Vulpes271/lap-timer/cad/LapTimerPrototype/exports/preview_bezel_back.png

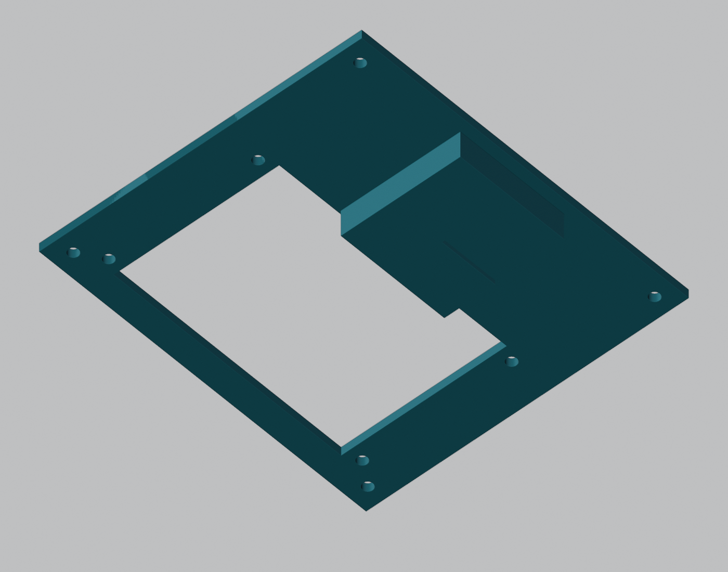
cad/LapTimerPrototype/exports/preview_bezel_back.png
