Vulpes271/lap-timer/cad/LapTimerPrototype/exports/preview_exploded.png

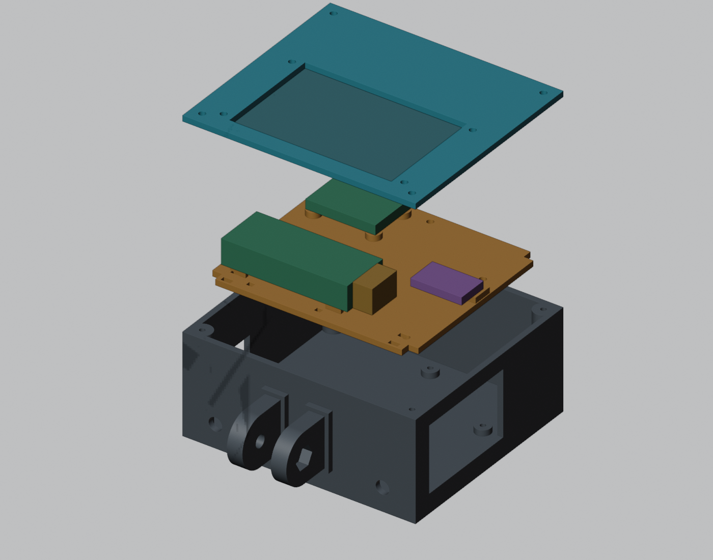
cad/LapTimerPrototype/exports/preview_exploded.png
