Vulpes271/lap-timer/cad/LapTimerPrototype/exports/preview_inside.png

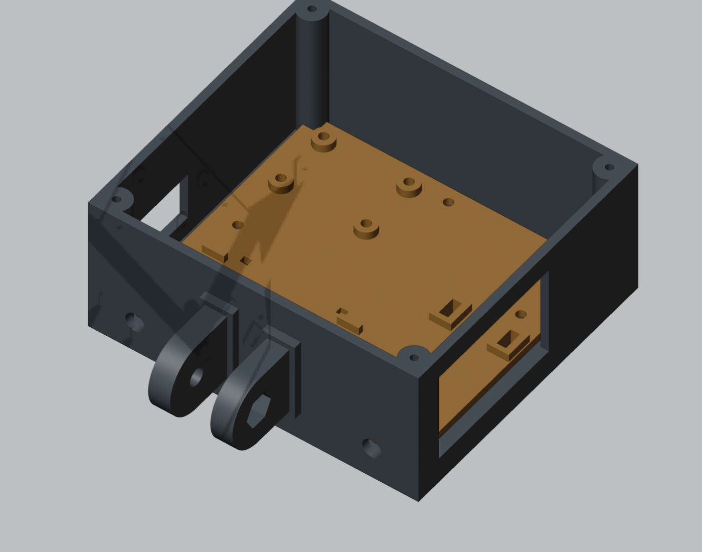
cad/LapTimerPrototype/exports/preview_inside.png
