Vulpes271/lap-timer/hardware/quote_v0/preview/architecture.png

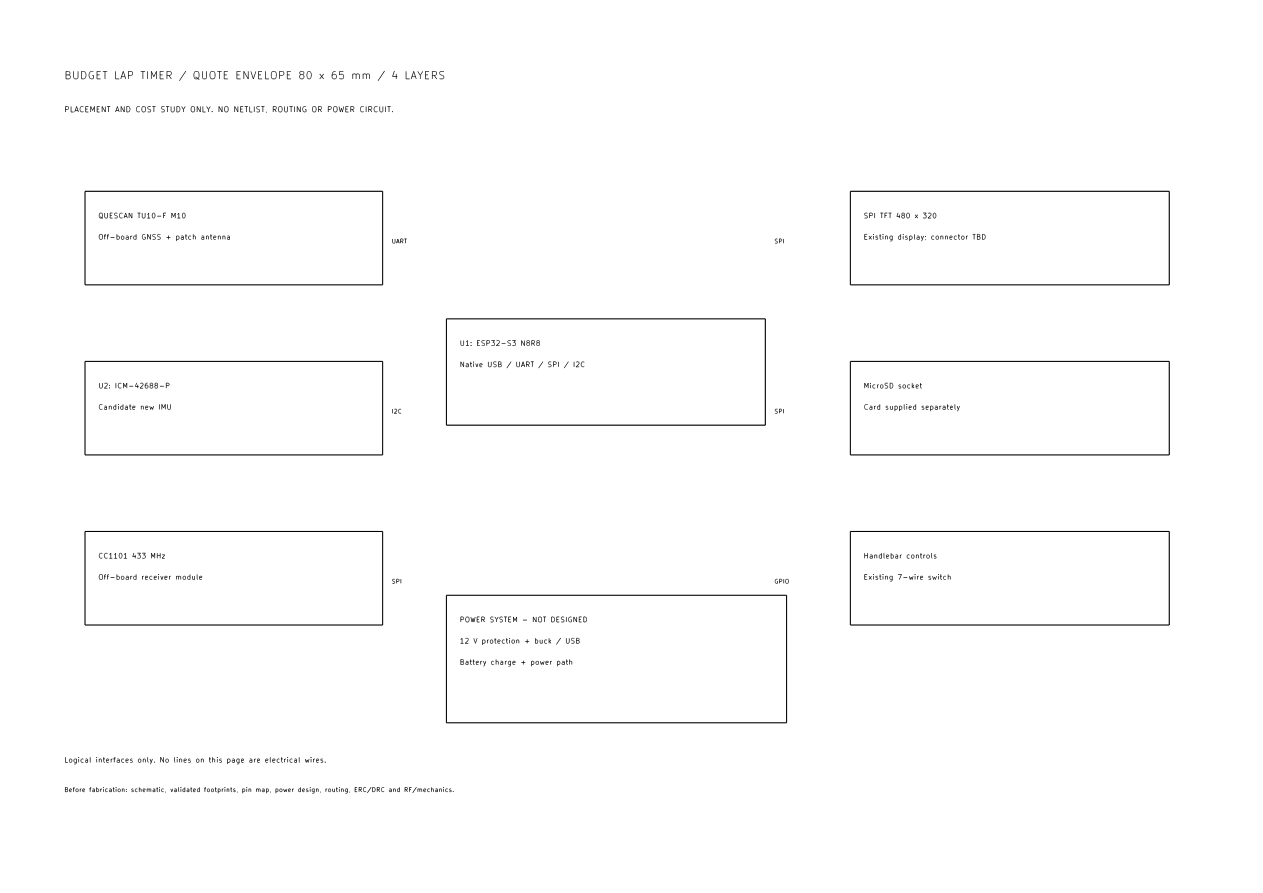
hardware/quote_v0/preview/architecture.png
