Vulpes271/lap-timer/hardware/quote_v0/preview/pcb_preview.png

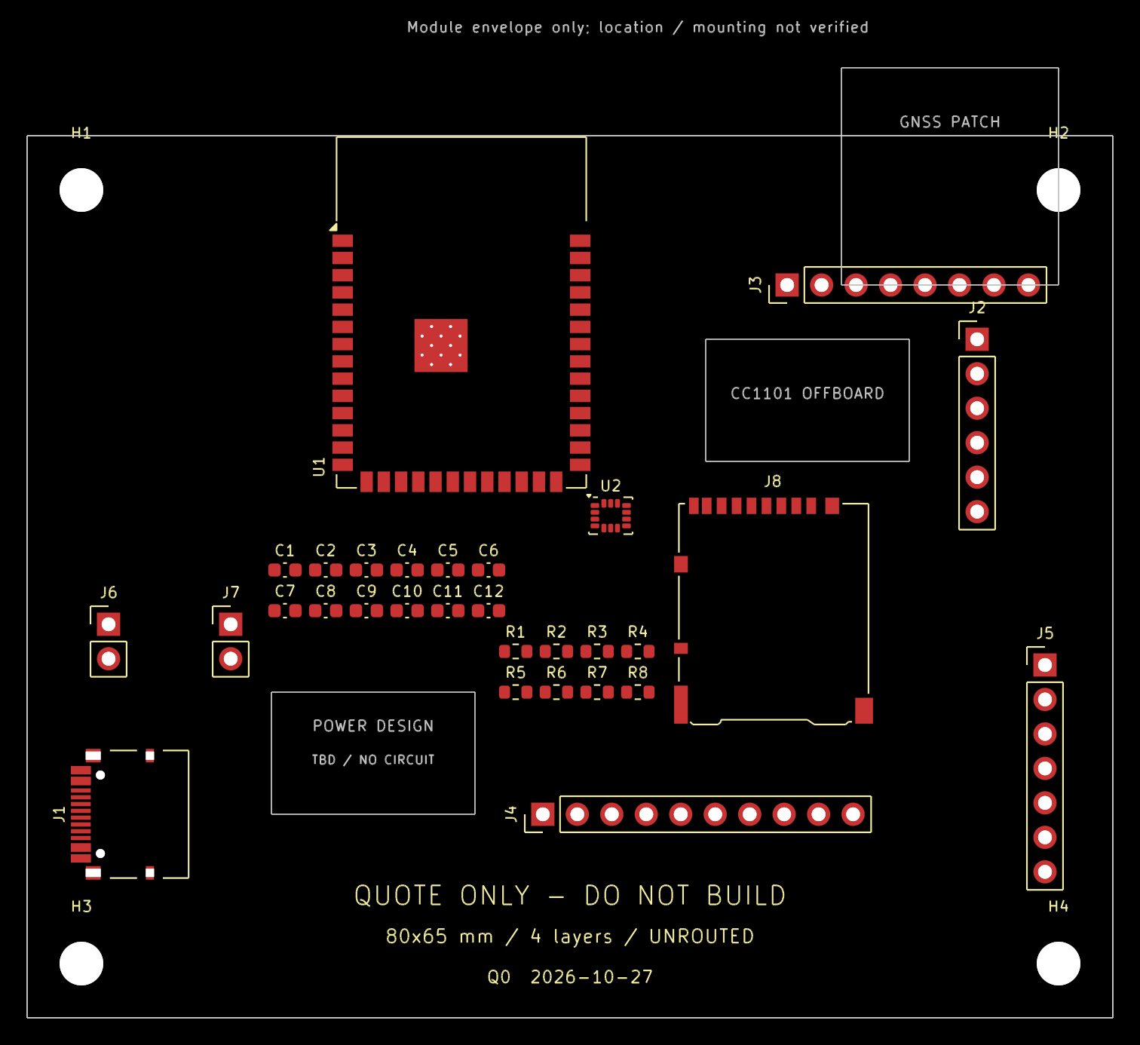
hardware/quote_v0/preview/pcb_preview.png
