Vulpes271/lap-timer/hardware/quote_v0/pcba_quote_subset/BOM_PARTIAL_QUOTE_ONLY.csv

Comment | Designator | Footprint | LCSC Part #
ESP32-S3-WROOM-1-N8R8 | U1 | ESP32-S3-WROOM-1 | C2913201
ICM-42688-P | U2 | LGA-14_3x2.5mm_P0.5mm_LayoutBorder3x4y | C1850418
