Vulpes271/lap-timer/cad/LapTimerPrototype/exports/LapTimer_assembled.step

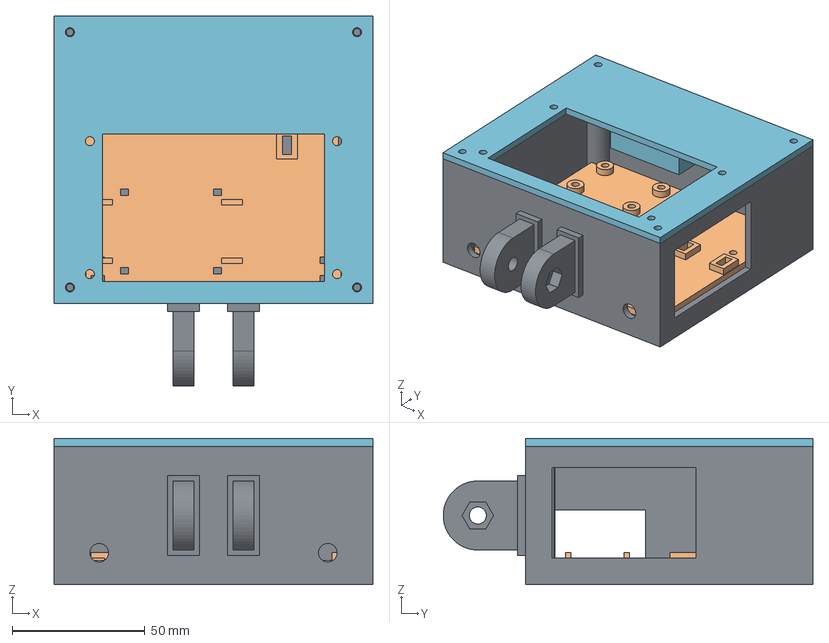
[picture p6: CAD file, 2026-11-06]
cad/LapTimerPrototype/exports/LapTimer_assembled.step
120.0 x 139.0 x 55.0 mm
01_Housing
02_Front_bezel
03_Electronics_carrier
