Vulpes271/lap-timer/cad/LapTimerPrototype/exports/02_Front_bezel.step

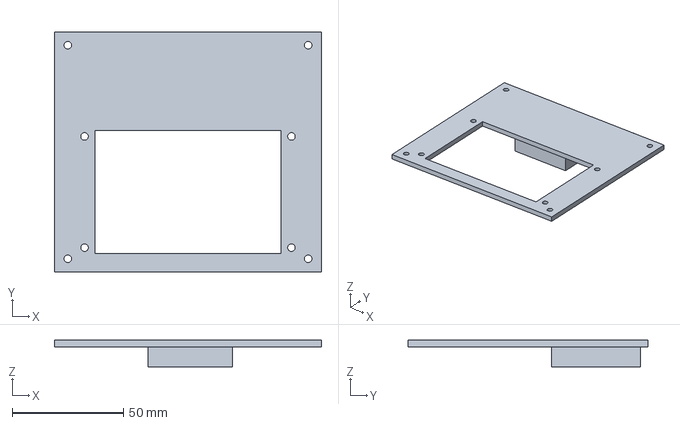
[picture p7: CAD file, 2026-11-06]
cad/LapTimerPrototype/exports/02_Front_bezel.step
120.0 x 108.0 x 12.0 mm
