Vulpes271/lap-timer/cad/LapTimerPrototype/exports/01_Housing.step

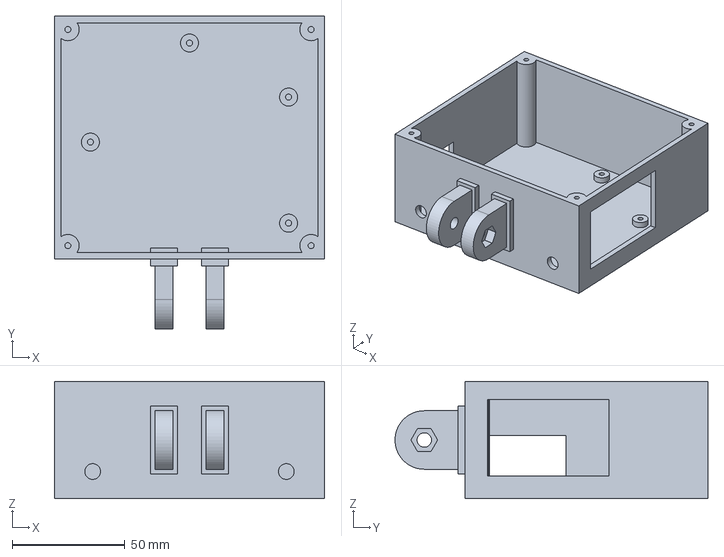
[picture p8: CAD file, 2026-11-06]
cad/LapTimerPrototype/exports/01_Housing.step
120.0 x 139.0 x 52.0 mm
