Vulpes271/lap-timer/cad/LapTimerPrototype/exports/03_Electronics_carrier.step

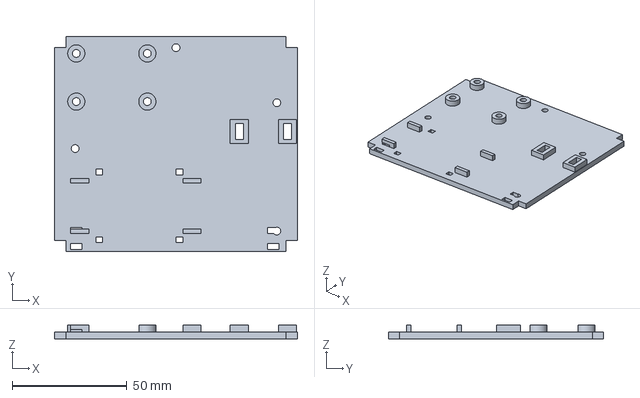
[picture p9: CAD file, 2026-11-06]
cad/LapTimerPrototype/exports/03_Electronics_carrier.step
106.0 x 94.0 x 6.00 mm
