Vulpes271/lap-timer/cad/LapTimerPrototype/exports/LapTimer_exploded.step

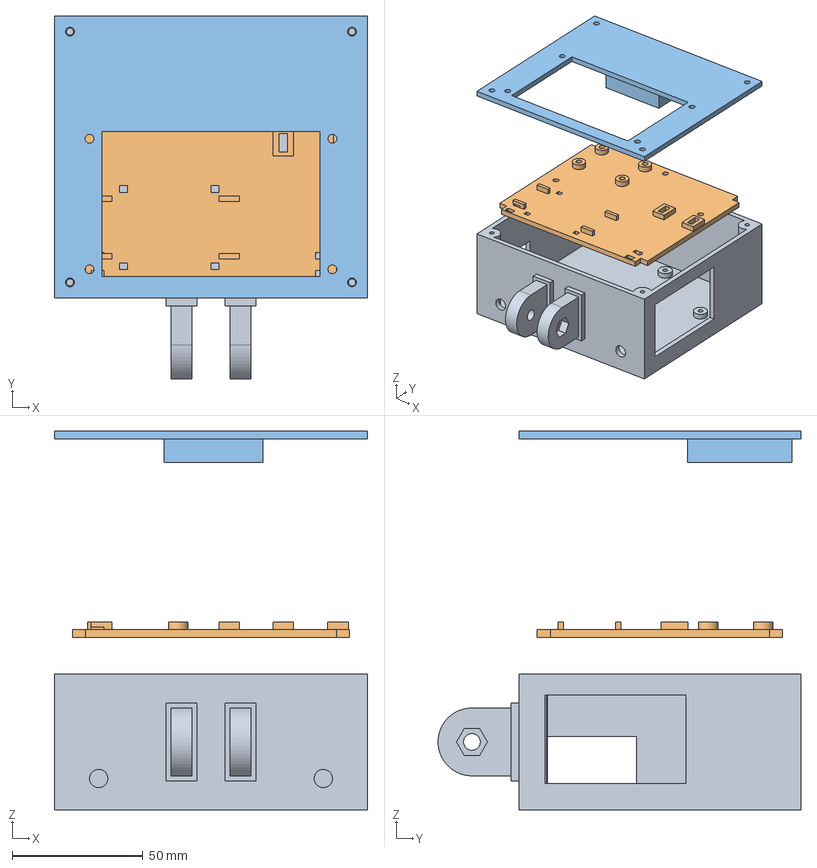
[picture p10: CAD file, 2026-11-06]
cad/LapTimerPrototype/exports/LapTimer_exploded.step
120.0 x 139.0 x 145.0 mm
01_Housing
03_Electronics_carrier
02_Front_bezel
