Vulpes271/lap-timer/cad/LapTimerPrototype/exports/04_Hinge_tongue_fit_gauge.step

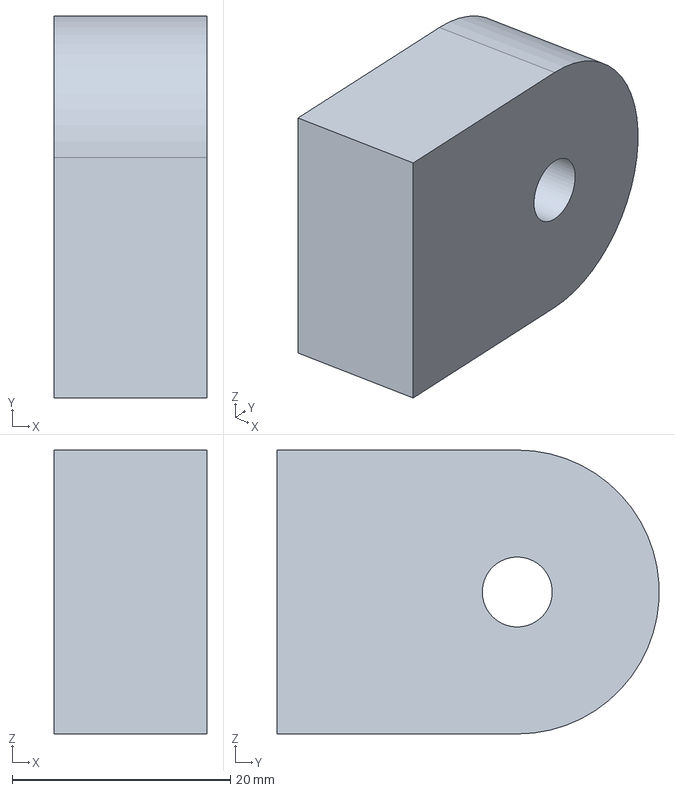
[picture p11: CAD file, 2026-11-06]
cad/LapTimerPrototype/exports/04_Hinge_tongue_fit_gauge.step
14.0 x 35.0 x 26.0 mm
