Vulpes271/lap-timer/cad/LapTimerPrototype/exports/05_Display_spacer_6mm.step

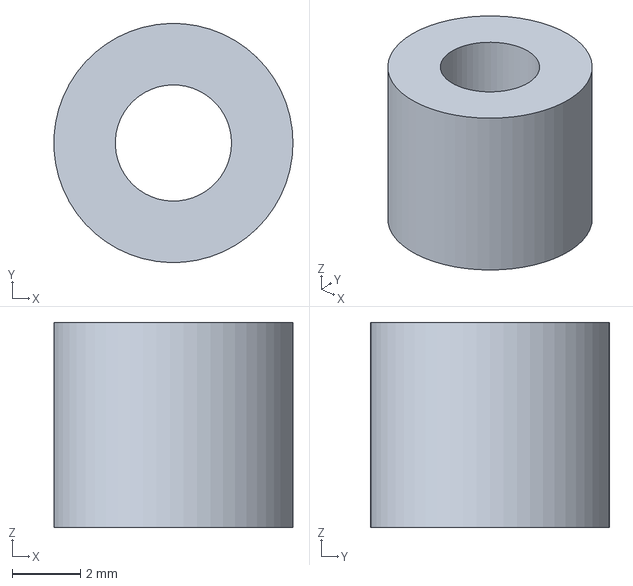
[picture p12: CAD file, 2026-11-06]
cad/LapTimerPrototype/exports/05_Display_spacer_6mm.step
6.99 x 7.00 x 6.00 mm
