Vulpes271/lap-timer/cad/LapTimerPrototype/exports/05_Display_spacer_2mm.step

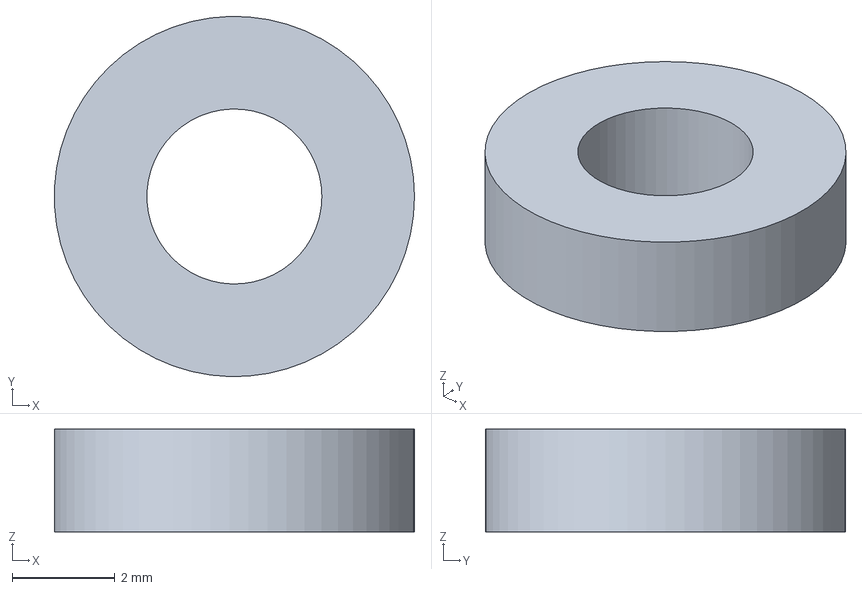
[picture p13: CAD file, 2026-11-06]
cad/LapTimerPrototype/exports/05_Display_spacer_2mm.step
7.00 x 7.00 x 2.00 mm
