Vulpes271/lap-timer/cad/LapTimerPrototype/exports/05_Display_spacer_4mm.step

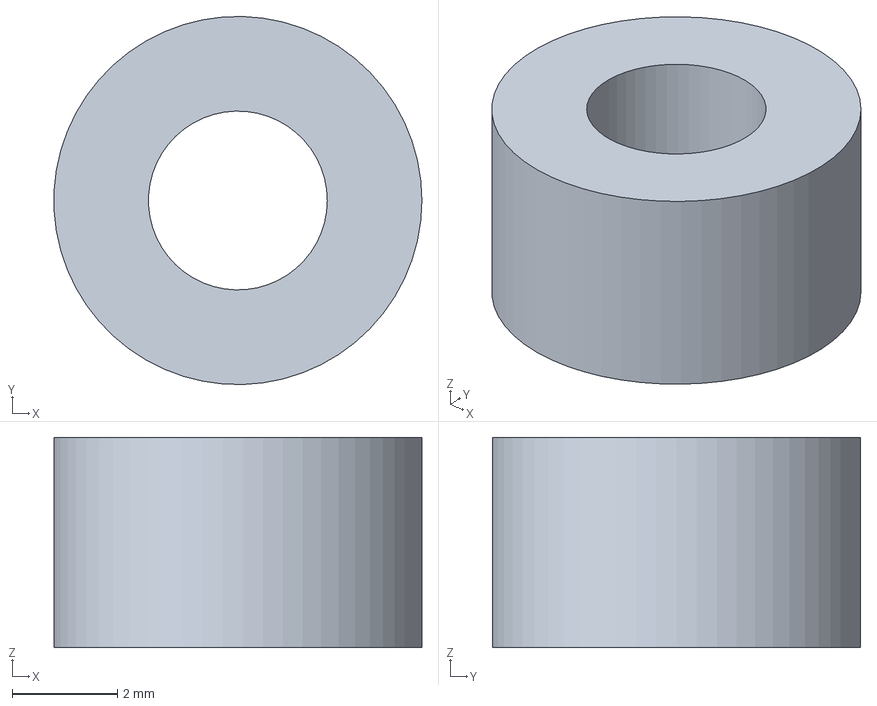
[picture p14: CAD file, 2026-11-06]
cad/LapTimerPrototype/exports/05_Display_spacer_4mm.step
6.99 x 7.00 x 4.00 mm
