Vulpes271/lap-timer/cad/LapTimerPrototype/exports/Component_envelopes_NOT_FOR_PRINT.step

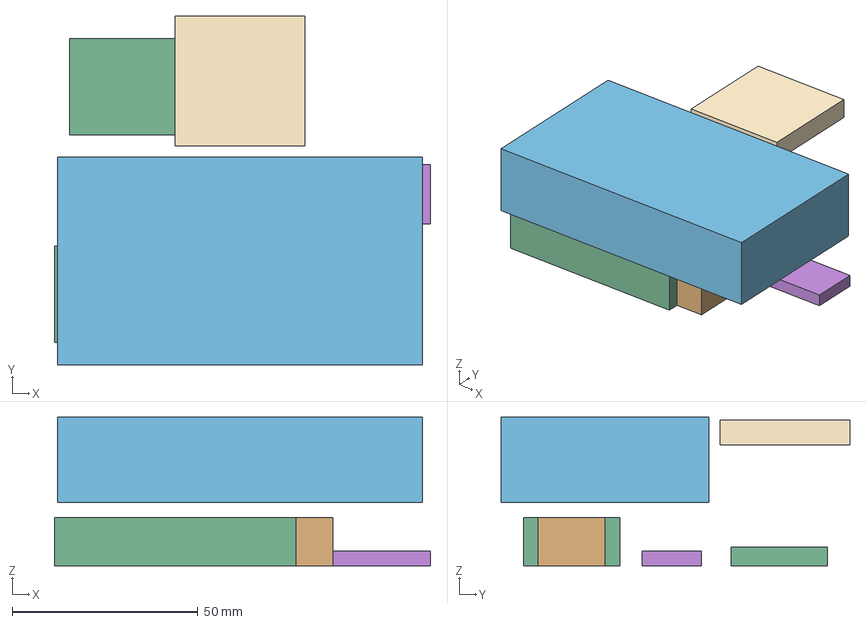
[picture p15: CAD file, 2026-11-06]
cad/LapTimerPrototype/exports/Component_envelopes_NOT_FOR_PRINT.step
101.3 x 94.0 x 40.0 mm
Display_envelope_-_connector_depth_included
ESP32_envelope
SD_protrusion_allowance
IMU_envelope_-_height_provisional
GPS_module
Antenna_envelope
