Vulpes271/lap-timer/(list of files, cad)

Other CAD files:
cad/LapTimerPrototype/exports/01_Housing.stl
cad/LapTimerPrototype/exports/02_Front_bezel.stl
cad/LapTimerPrototype/exports/03_Electronics_carrier.stl
cad/LapTimerPrototype/exports/04_Hinge_tongue_fit_gauge.stl
cad/LapTimerPrototype/exports/05_Display_spacer_2mm.stl
cad/LapTimerPrototype/exports/05_Display_spacer_4mm.stl
cad/LapTimerPrototype/exports/05_Display_spacer_6mm.stl
cad/LapTimerPrototype/exports/LapTimer_preview.blend
