Vulpes271/lap-timer/cad/LapTimerPrototype/exports/preview_assembled.png

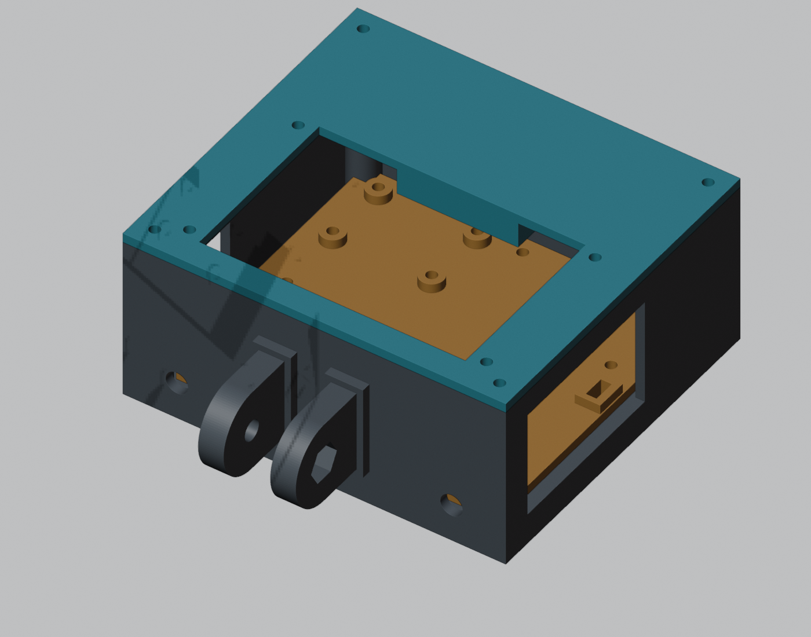
cad/LapTimerPrototype/exports/preview_assembled.png
