Vulpes271/lap-timer/(commit log)

2026-10-24 Prva verzija: povezava GPS, IMU in zaslona
2026-10-26 Dodaj upravljanje SD, vodeno kalibracijo IMU in pregled implementacije
2026-10-26 Optimizirana verzija
    Ohranjeno upravljanje z gumbi, BACK na prvi vrstici, locena QUICK INFO in LAP DELTA ter razvojni build za simulator in teste. Posodobljena dokumentacija.
    Znana napaka: zaslon CAMERA se trenutno prikazuje enako kot RACE; popravek ostaja odprt.
2026-10-27 Add quote-only KiCad layout, Gerbers and partial PCBA import files
2026-11-06 Add PETG enclosure prototype with Fusion script and printable CAD files
